damienmaguire/Lexus-GS450H-Inverter-Controller/GS450H_VCU_V1_BOM.ods

LEXUS GS450H INVERTER CONTROLLER BOM V1
Ref Name | Qty | Component | Value | Manufacturer | MPN | RS Part Number | Mouser Part Number | Description
D1,D2,D3,D4 | 4 | 1N4148W-7-F |  | Diodes Inc. | 1N4148W-7-F | 7384728P |  | Diode Switching 150mA 100V 400mW SOD123 Diodes Inc 1N4148W-7-F Switching Diode 100V, 2-Pin SOD-123
CONN1 | 1 | 75867-101LF |  | FCI | 75867-101LF | 6737635 |  | 10w R/A T/H boxed header Quickie Amphenol FCI Quickie Series, 2.54mm Pitch 10 Way 2 Row Shrouded Right Angle PCB Header, Through Hole
CONN2 | 1 | 5787834-1 |  | TE Connectivity | 5787834-1 | 5298224 |  | USB type B vertical thru-hole socket
IC5 | 1 | ATSAM3X/AAU | ATSAM3X8EA-AU | Microchip | ATSAM3X8EA-AU | 131-1191 | 556-ATSAM3X8EA-AU | ATSAM3X8EA-AU, 32bit ARM Cortex M3 Microcontroller, 84MHz, 512 kB Flash, 144-Pin LQFP
C36 | 1 | C_0805 | 0.01UF | AVX | 08055F103KAT2A | 698-3462 |  | 10nF Multilayer Ceramic Capacitor MLCC 50V dc ±10% X8R Dielectric 0805 (2012M)
C22,C20,C12,C7,C21,C6,C33,C16,C11,C4,C8,C19,C26,C17,C10,C13,C28,C3,,C38,C1,C27,C114,C116,C118,C123,C124,C125,C126,C34 | 29 | C-USC0805 | 0.1u | MURATA | GRM219R71C104KA01D | 790-0667 |  | 100nF Multilayer Ceramic Capacitor MLCC 16V dc ±10% X7R Dielectric 0805 (2012M)
C5,C2,C35,C43,C9,C120,C121,C122,C30 | 9 | C-USC0805 | 1UF | KEMET | C0805C105K4RACTU | 451-5770 |  | 1μF Multilayer Ceramic Capacitor MLCC 16V dc ±10% X7R Dielectric 0805 (2012M)
C44,C37,C15,C23,C32,C45 | 6 | C-USC0805 | 10u | MURATA | GRM21BR61E106KA73L | 790-0673 |  | 10μF Multilayer Ceramic Capacitor MLCC 25V dc ±10% X5R Dielectric 0805 (2012M)
C25,C29,C24 | 3 | C-USC0805 | 22p | AVX | 08051A220JAT2A | 464-6587 |  | 22pF Multilayer Ceramic Capacitor MLCC 100V dc ±5% C0G Dielectric 0805 (2012M)
C40,C110,C115,C117,C119 | 5 | C-USC0805 | 47nF | AVX | 08055F473KAT2A | 698-3516 |  | 47nF Multilayer Ceramic Capacitor MLCC 50V dc ±10% X8R Dielectric 0805 (2012M)
C14,18 | 2 | C-USC1206 | 22p | AVX | 12061A220JAT2A | 136-4302 |  | AVX 22pF Multilayer Ceramic Capacitor (MLCC) 100V dc ±5% 1206 (3216M)
C41 | 1 | Cap_el | 100uF | RSPRO | 711-0703 | 711-0703 |  | Aluminium Electrolytic Capacitor 100μF 6.3V dc 5mm Through Hole
Y1 | 1 | CRYSTAL-3.2-2.5 | 12MHz KX-7 20pF | ECS | ECS-120-20-33-CKM-TR |  | 520-120-20-33-CKMT | Crystals 12.000MHz 20pF 10ppm -20C +70C
C42 | 1 | C_0805 | 10uF | MURATA | GRM21BR61E106KA73L | 790-0673 |  | 10μF Multilayer Ceramic Capacitor MLCC 25V dc ±10% X5R Dielectric 0805 (2012M)
C31 | 1 | ECA1AAD221X | 220uF 10V | Panasonic | ECA1AAD221X | 7270786P |  | Panasonic 220uF 10V dc Aluminium Electrolytic Capacitor, Through Hole 8 (Dia.) x 5mm +85C 8mm 0.5mm
C39 | 1 | EEU-FM1E681 | 680uF 35V | Panasonic | EEU-FM1E681 |  |  | PANASONIC ELECTRONIC COMPONENTS - EEU-FM1E681 - \94DD\7535\89E3\7535\5BB9, 680UF, 25V, \5F84\5411\5F15\7EBF
S1,S2 | 2 | EVQPE505K |  | Panasonic | EVQPE505K | 7561565 |  | Tact switch,THT,SPST,black,1.6N op force Black Push Plate Tactile Switch, SPST-NO 50 mA 5mm
IC14 | 1 | FDT457N |  | Fairchild Semiconductor | FDT457N |  |  | FDT457N, N-channel MOSFET Transistor 5 A 30 V, 4-Pin SOT-223
IC8 | 1 | ITS4060SSJNXUMA1 |  | Infineon | ITS4060SSJNXUMA1 | 1660803 |  | Power Switch ICs - Power Distribution MINI-PROFET
LD1 | 1 | LD1117SOT223 | LD1117-3.3 | STMICROELECTRONICS | LD1117S33CTR | 686-9388 |  | LD1117S33CTR, LDO Regulator, 1.3A, 3.3 V, ±1% 3+Tab-Pin, SOT-223
LED1,LED2 | 2 | LED0805 |  | Wurth Elektronik | 150080SS75000 | 815-4234 |  | Wurth Elektronik 150080SS75000, WL-SMCW 630 nm Red LED, 2012 (0805) Clear SMD package
IC2 | 1 | M24M02-DRMN6TP |  | STMicroelectronics | M24M02-DRMN6TP | 8805333 |  | STMicroelectronics M24M02-DRMN6TP EEPROM Memory, 2Mbit, 450ns, 1.8 5.5 V 8-Pin SOIC
D5 | 1 | MBRS540T3G |  | ON Semiconductor | MBRS540T3G | 1250012 |  | Diode Schottky 40V 5A SMC ON Semiconductor MBRS540T3G Schottky Diode, 5A, 40V, 2-Pin SMC
CONN4 | 1 | Modice40 |  | Cinch | 581-01-40-011 |  | 538-581-01-40-011 | Automotive Connectors MODICE ME-MX 40 POSITION
IC1,IC3,IC4,IC6,IC7 | 5 | NCV8401ADTRKG |  | ON Semiconductor | NCV8401ADTRKG | 8079877 |  | Power Load Distribution Switch IC, Low Side, 1 Output, ± 14 V in, 16 A, 0.034 ohm
R17,R14,R22,R21,R85,R86,R87,R88,R89,R90,R91,R92,R94,R96,R98 | 15 | R-US_R0805 | 1K | RSPRO | 804-6449 | 804-6449 |  | Thick Film Surface Mount Fixed Resistor 0805 Case 1kΩ ±1% 0.125W
R6,R2,R8 | 3 | R-US_R0805 | 1K5 | RSPRO | RS-0805-1k5 | 713-6954 |  | Thick Film Surface Mount Fixed Resistor 0805 Case 1.5kΩ ±5% 0.125W
R93,R95,R97,R99 | 4 | R-US_R0805 | 1K8 | RSPRO | RS-0805-1k8 | 804-6470 |  | Thick Film Surface Mount Fixed Resistor 0805 Case 1.8kΩ ±5% 0.125W
R5,R1,R3,R4,R7 | 5 | R-US_R0805 | 4K7 | RSPRO | RS-0805-4k7 | 713-6998 |  | Thick Film Surface Mount Fixed Resistor 0805 Case 4.7kΩ ±5% 0.125W
R10 | 1 | R-US_R0805 | 6k8 1% | RSPRO | 804-6515 | 804-6515 |  | Thick Film Surface Mount Fixed Resistor 0805 Case 6.8kΩ ±1% 0.125W
R11,R12 | 2 | R-US_R0805 | 39R | RSPRO | 804-6335 | 804-6335 |  | Thick Film Surface Mount Fixed Resistor 0805 Case 39Ω ±1% 0.125W
R20,R15,R77,R78,R79,R80,R81,R82,R83,R84 | 10 | R-US_R0805 | 60R4 | RSPRO | RS-0805-60R4 | 717-2130 |  | Thick Film Surface Mount Fixed Resistor 0805 Case 60.4Ω ±1% 0.125W
R13 | 1 | R-US_R0805 | 100k | RSPRO | 804-6607 | 804-6607 |  | Thick Film Surface Mount Fixed Resistor 0805 Case 100kΩ ±1% 0.125W
R16,R9 | 2 | R-US_R0805 | 390R | RSPRO | RS-0805-390R | 713-6907 |  | Thick Film Surface Mount Fixed Resistor 0805 Case 390Ω ±5% 0.125W
Y2 | 1 | RESONATOR_EPSON_FC_145 | 32.768Khz | EPSON TOYOCOM | FC-135 32.768KHz 20ppm, 7pF | 667-6094 |  | SMD Crystal 32.768kHz, ±20ppm, 2-Pin, 3.2 x 1.5 x 0.8mm
IC9,IC11,IC12,IC13,IC15 | 5 | SN65HVD234 | SN65HVD234 | Texas Instruments | SN65HVD234D | 662-4315 |  | SN65HVD234D, CAN Transceiver 1MBps 1-channel ISO 11898
L5,L6,L7,L8 | 4 | SRF0905-102Y |  | Bourns | SRF0905-102Y | 7633402P |  | Bourns SRF0905 Series Type 0905 Wire-wound SMD Inductor with a Ferrite Core, 1 mH +/-50% Wire-Wound 800mA Idc
IC10 | 1 | TR10S05 |  | XP POWER | TR10S05 | 1346949 |  | XP Power Switching Regulator, 8 28V dc Input, 5V dc Output, 1A
R18,R19 | 2 | VARISTORCN0603 | CG0603MLC-05E | Bourns | CG0603MLC-05E | 851-8256 |  | MLC Series Power Varistor 0.5pF, Clamping 20V 0603 (1608M)
L1,L2,L3,L4 | 4 | WE-CBF_0805 | MH2029-300Y | Bourns | MH2029-300Y |  | 652-MH2029-300Y | Ferrite Beads 30 ohms 25% HIGH CURRENT
Cinch Enclosure | 1 |  |  | Cinch | 5810130065 |  | 538-581-01-30-065 | Connector Accessory, Enclosure, Cinch ModICE SE Series Modular Connector Enclosures
