damienmaguire/Lexus-GS450H-Inverter-Controller/(threads)

Thread 2 (2020-05-31):

Include Framework info for packaging external dependancies.

JoNilsson, 2020-05-31:
Can you please help others build this by adding information about the specific frameworks that you used to compile this project.

I'm using Platform I/O, and it has a great library search feature, but files like `FS.h` are much to vague to extrapolate what specific file system library you were using.

Alternatively, include a the externalities in a `lib` folder.

https://github.com/damienmaguire/Lexus-GS450H-Inverter-Controller/blob/3857ae034eb1e618544211309efd0ab1a16a66c4/WiFi/GS450H_WiFi_V1.ino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

Burritobun, 2020-11-19:
I second this as I'm attempting to build as well. Eventually want to add my own features in.

DOSputin, 2020-11-22:
> I second this as I'm attempting to build as well. Eventually want to add my own features in.

It seems that the Author of the repository does not interact via Github.  The Author sporadically communicates on https://openinverter.org/forum/.   It's a mess, like most forums,  but I think that the info that we are seeking might be somewhere in one of the threads there.  You might try sleuthing through some of it.  If you figure it out, please post your results here.   I will do the same.

aleksandrortin, 2023-05-15:
Дорогой друг

Так что извините за беспокойство.

Но нам нужно подтвердить стек с вами, пожалуйста, поймите.

Поскольку в вашем файле есть два внутренних слоя, но мы не уверены в ранге.

Как показано стрелкой, как показано ниже
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

Слой GND (розовая стрелка)

Слой VCC (синяя стрелка)

А или Б, как правильно? Не могли бы вы подтвердить это с вашей командой?

A: L2: Земля L3: VCC

B: L2: VCC L3: Земля

Ваш ранний ответ будет высоко оценен!

С наилучшими пожеланиями
