damienmaguire/Lexus-GS450H-Inverter-Controller/GS450H_VCU_V1 - Schematic.pdf

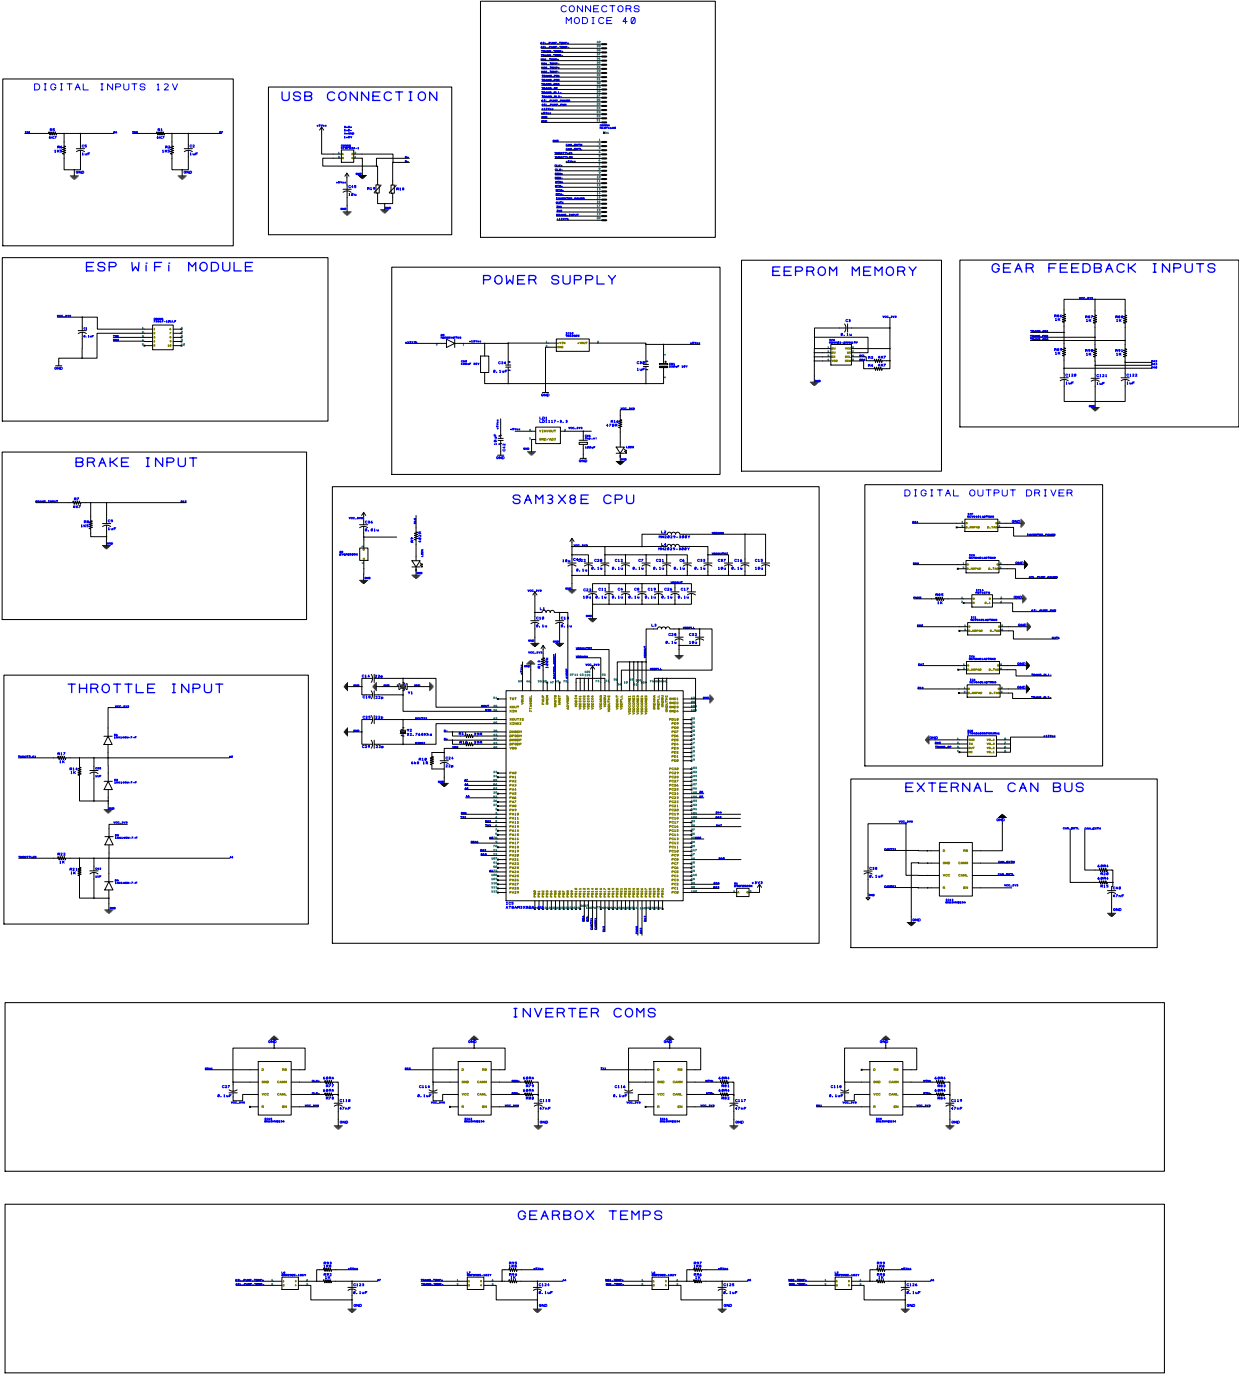
[picture p2: page 1]
