damienmaguire/Lexus-GS450H-Inverter-Controller/GS450H_VCU_V1 - PCB.pdf

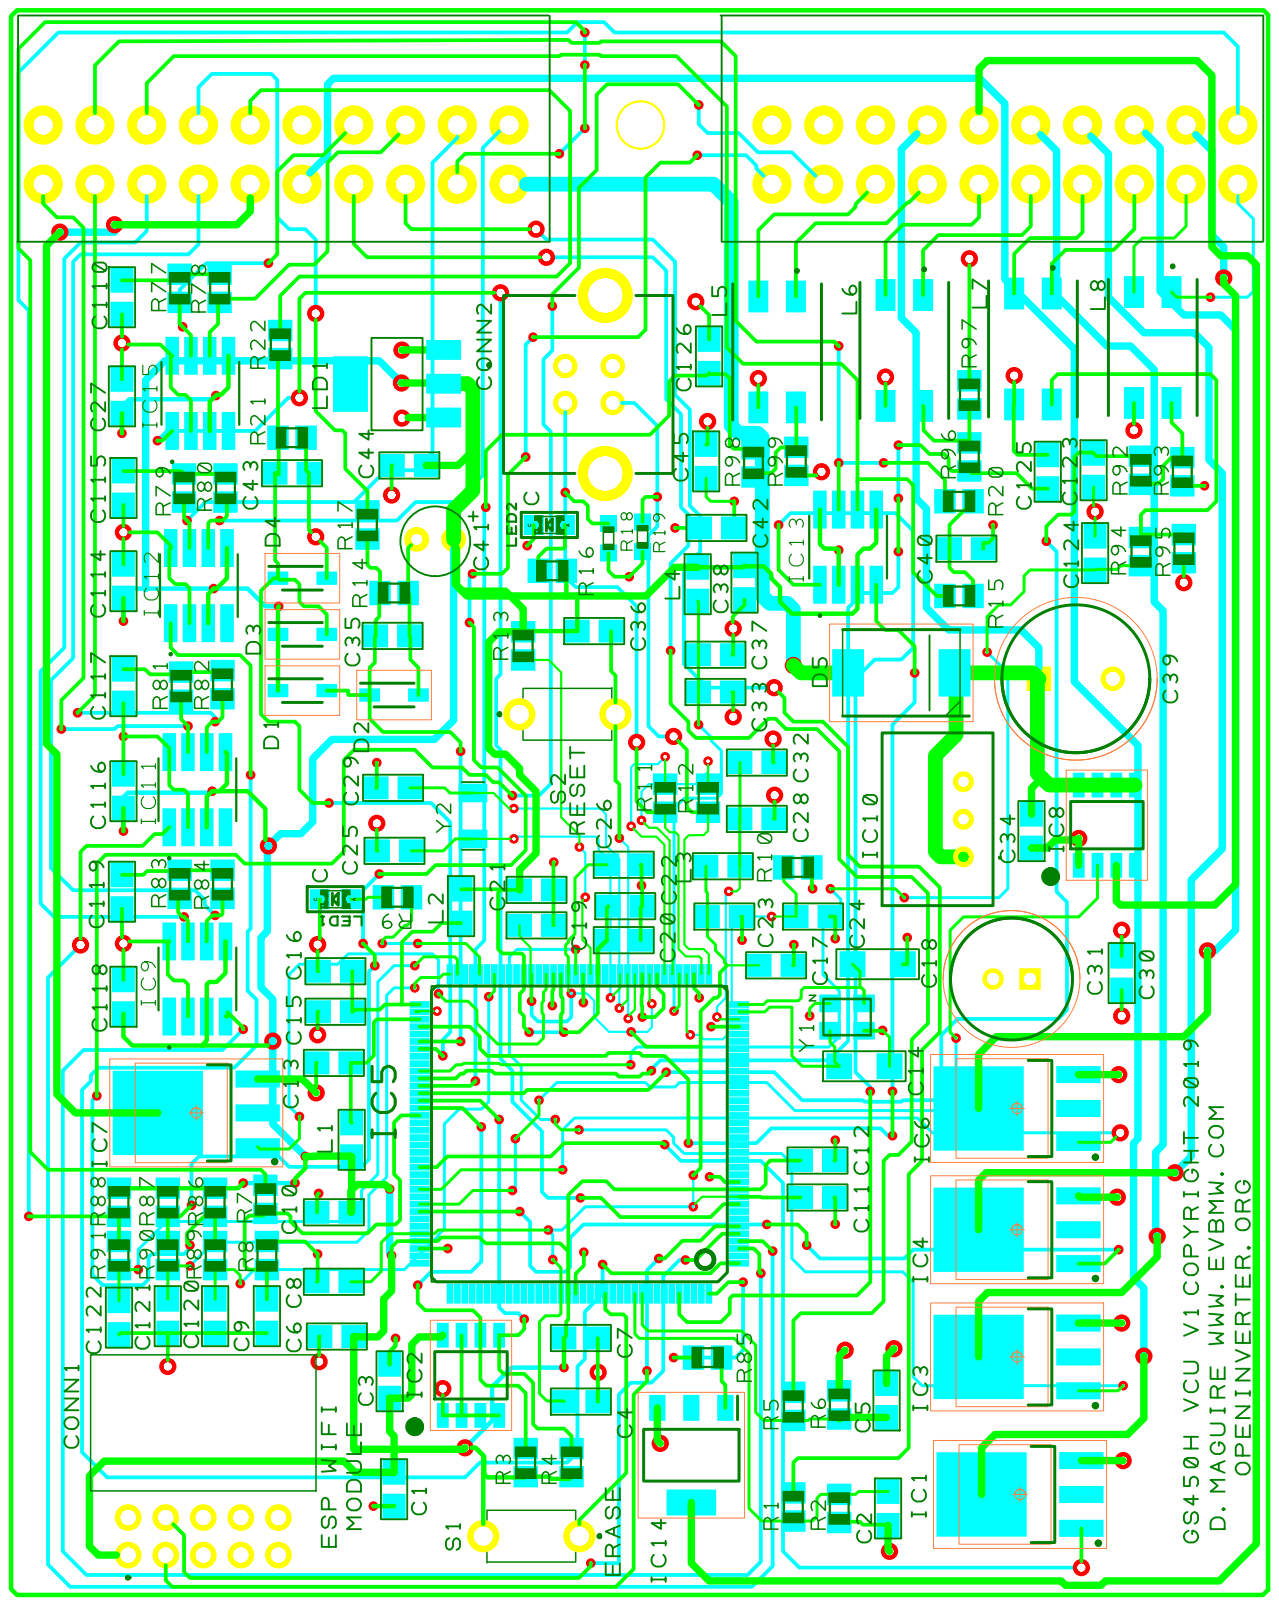
[picture p3: page 1]
