damienmaguire/Lexus-GS450H-Inverter-Controller/V2/GS450H_VCU_V2 - Schematic.pdf

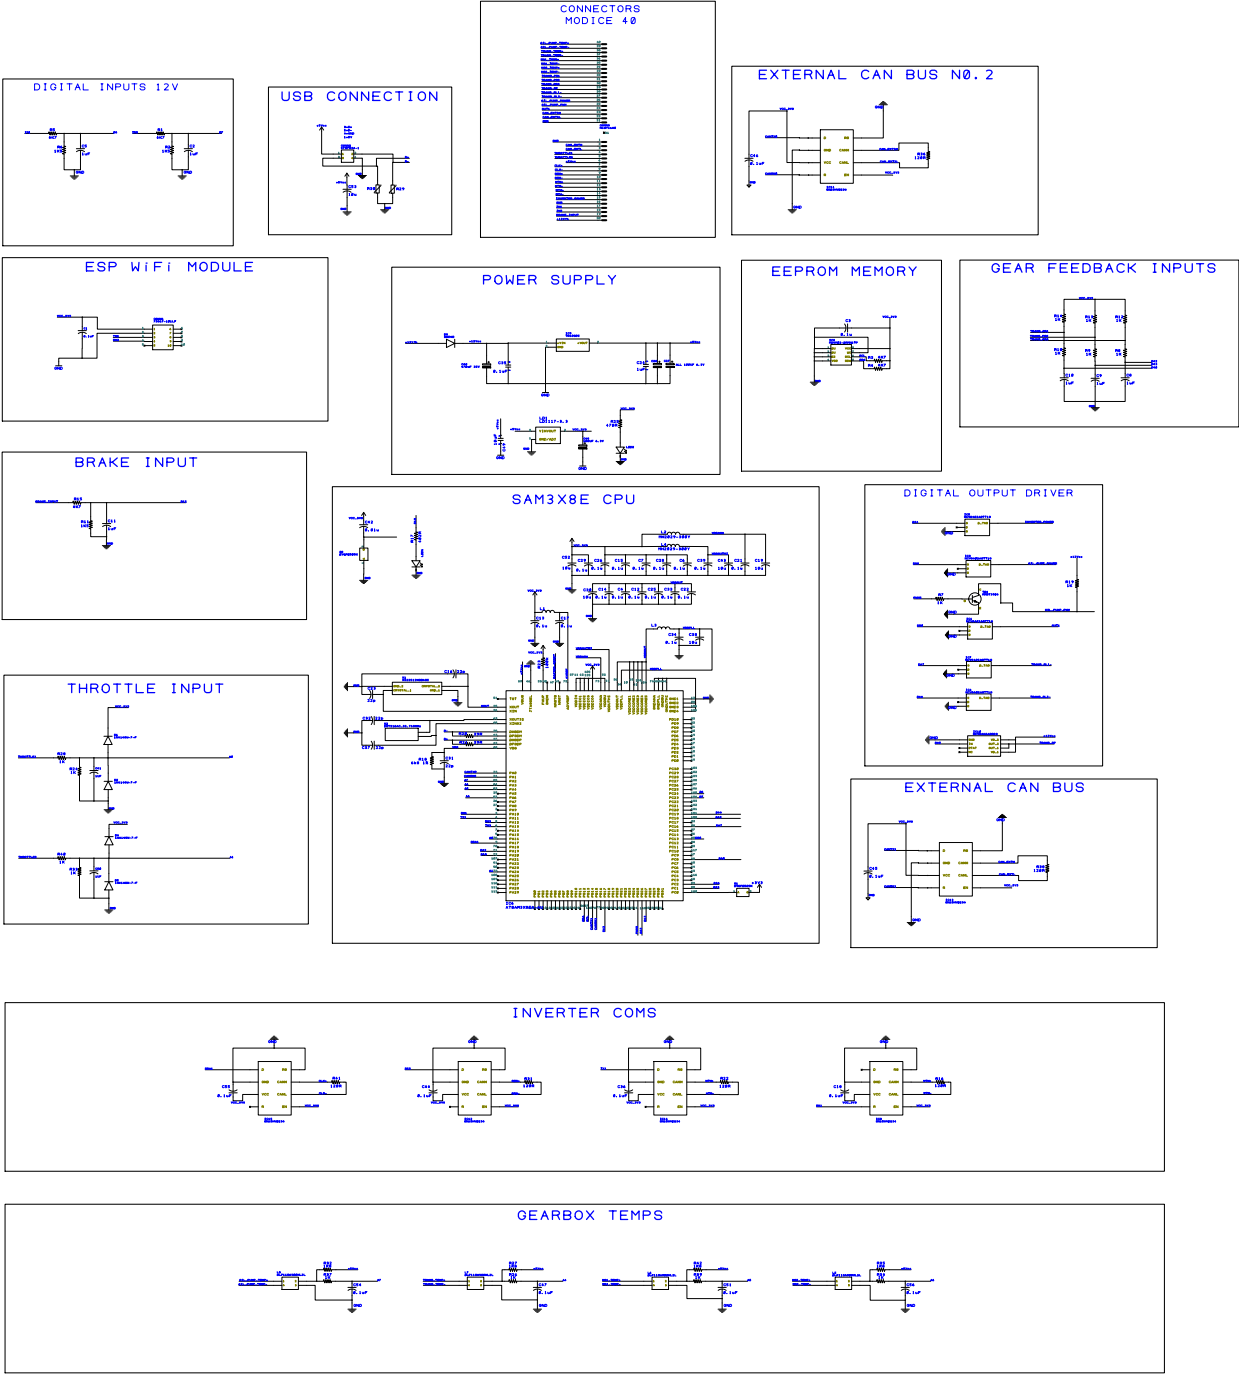
[picture p4: page 1]
