damienmaguire/Lexus-GS450H-Inverter-Controller/V2/GS450H_VCU_V2 - PCB.pdf

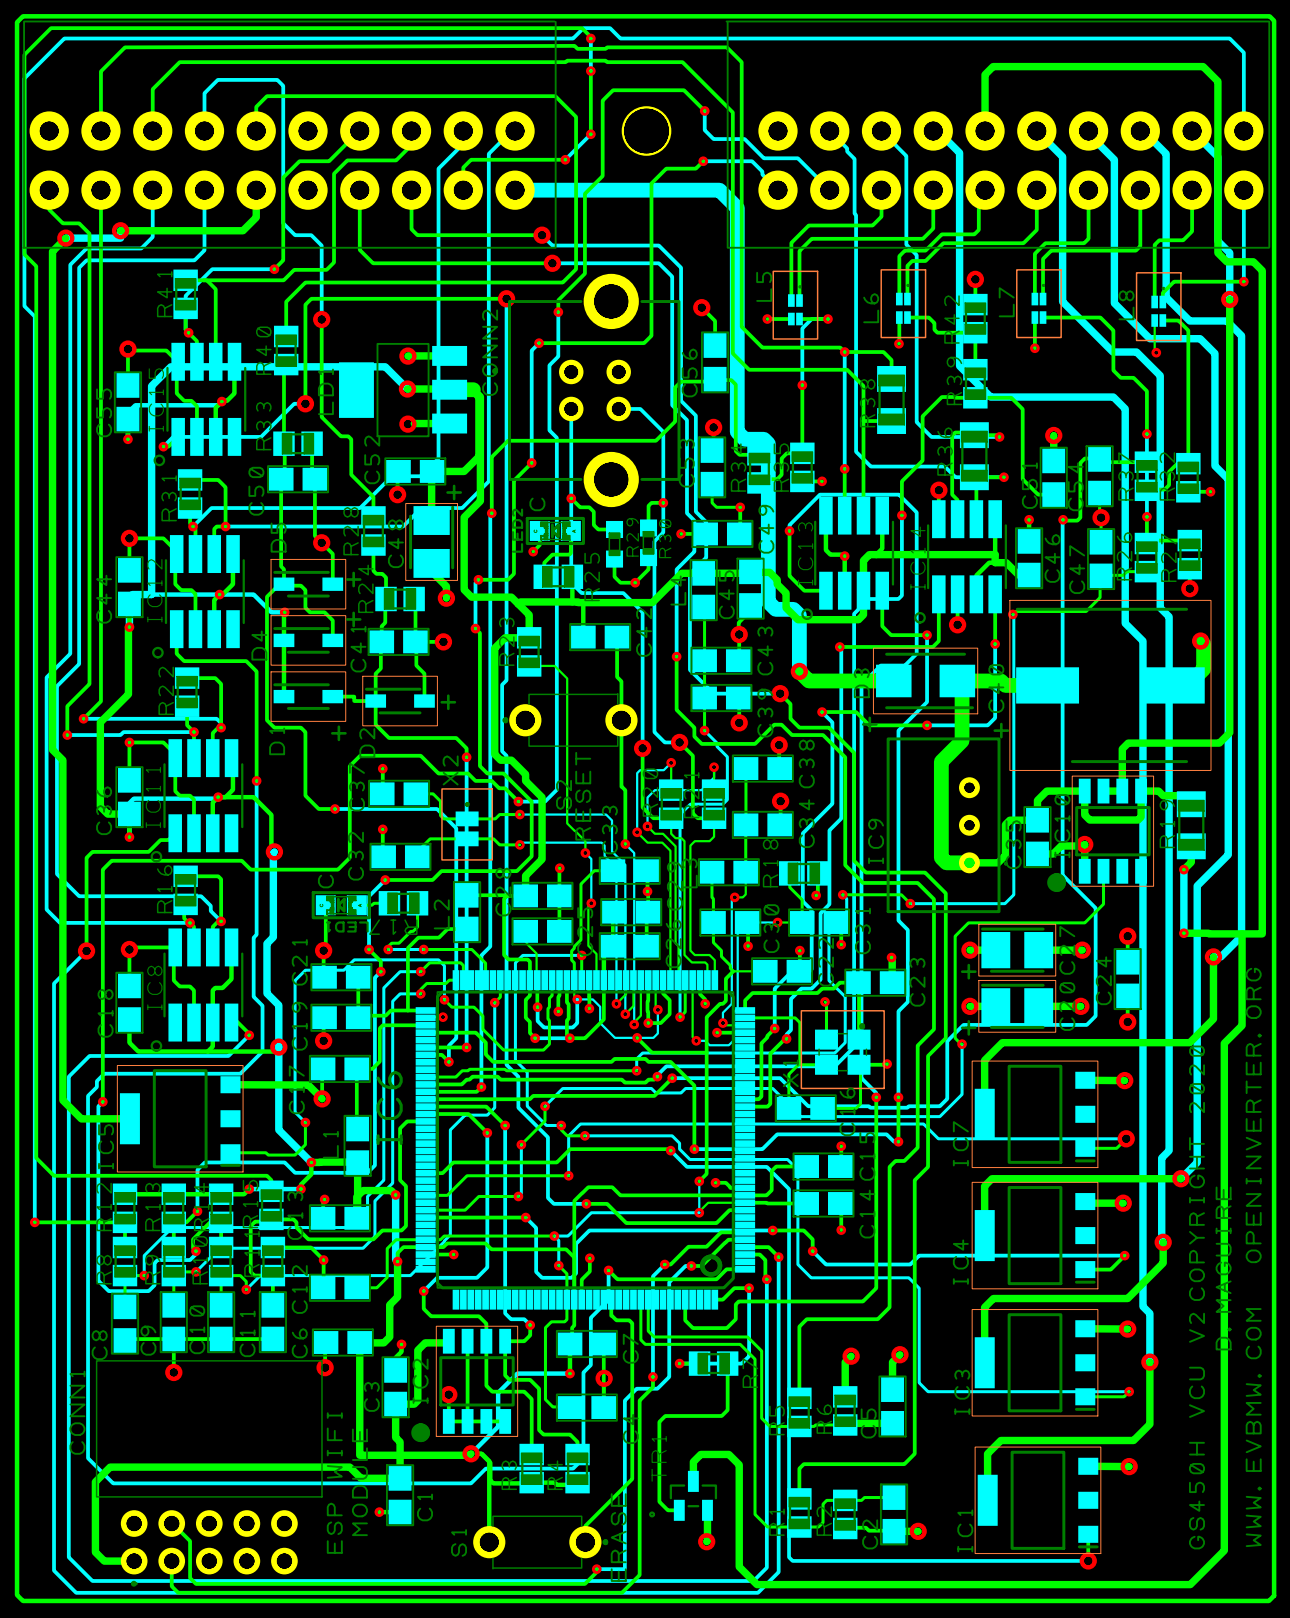
[picture p5: page 1]
