damienmaguire/Lexus-GS450H-Inverter-Controller/(list of files, drawings)

Other design files:
GS450H_VCU_V1.pcb
V2/GS450H_VCU_V2.pcb
