damienmaguire/Lexus-GS450H-Inverter-Controller/(commit log)

2021-05-13 Adding regen braking
    First attempt at adding regen. Max regen torque is 1/8 of max torque, and first 20% of pedal travel is regen range. No regen under 100rpm
2021-05-13 Eliminated runaway backwards accel bug
    If you were rolling backwards down a San Francisco hill and passed -100rpm, the car would have accelerated backward! Fixed that.
    [gs450h_v3_user.ino]
2021-05-14 Constant 5% dead zone
    Replaced code that had throttle always starting at 25% with a variable dead zone that is always 5%. At low RPM, positive torque starts at 5% throttle, and at 1000rpm, positive torque starts at 25% throttle.
    [gs450h_v3_user.ino]
2021-05-31 Regen hardcoded
    Regen working on the GS450h.
    Hardcoded max drive torque 3500 and max regen torque 1750
2021-05-31 Tried scaling torque to user setting
    No luck yet
2021-06-04 Added user defined torque values
    Scaled nominal map based torque value by the user defined maximum value. Baseline numbers are 3500 drive, 1750 reverse total torque, and are scaled from there
    [gs450h_v3_user.ino]
